dfitzsimo-svg/PFD_Project2/Pictures/3D PCB (routing done) (Draft 1).png

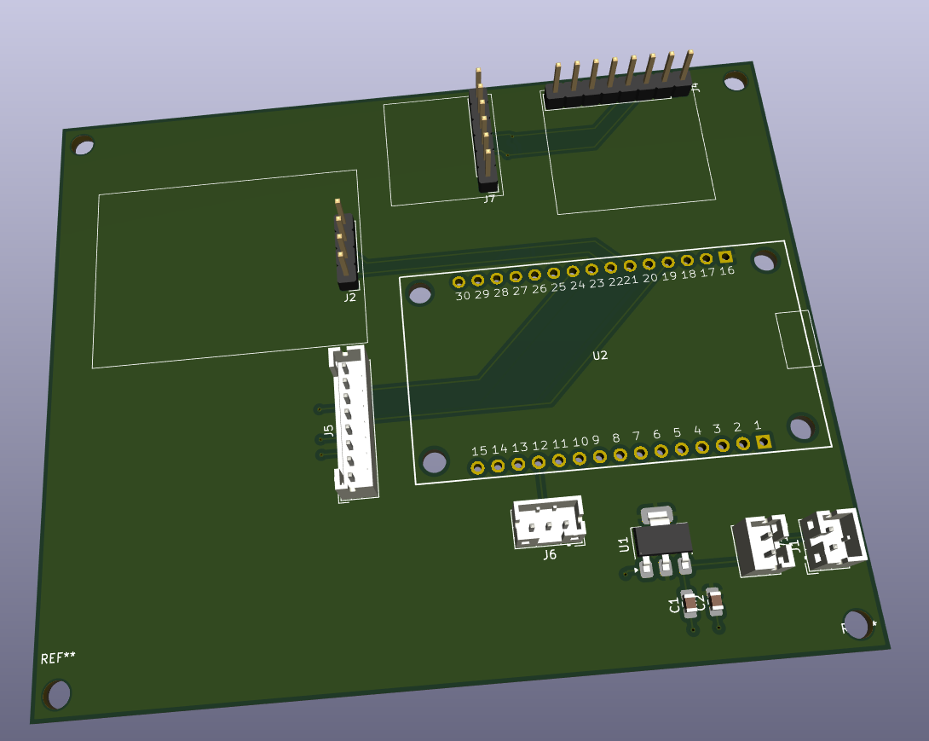
Pictures/3D PCB (routing done) (Draft 1).png
