dfitzsimo-svg/PFD_Project2/Pictures/Final PCB Design.png

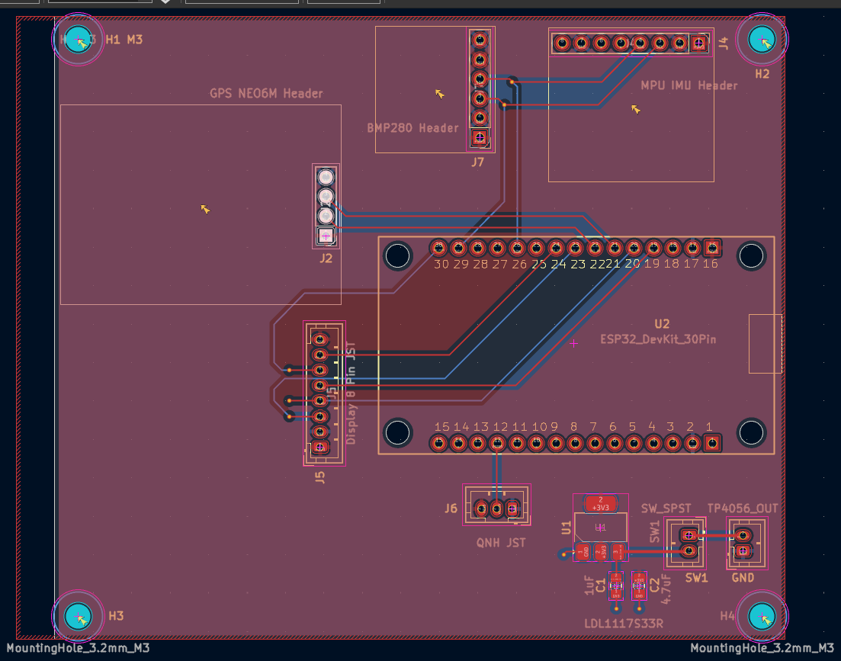
Pictures/Final PCB Design.png
