dfitzsimo-svg/PFD_Project2/Pictures/Laying out traces on PCB.png

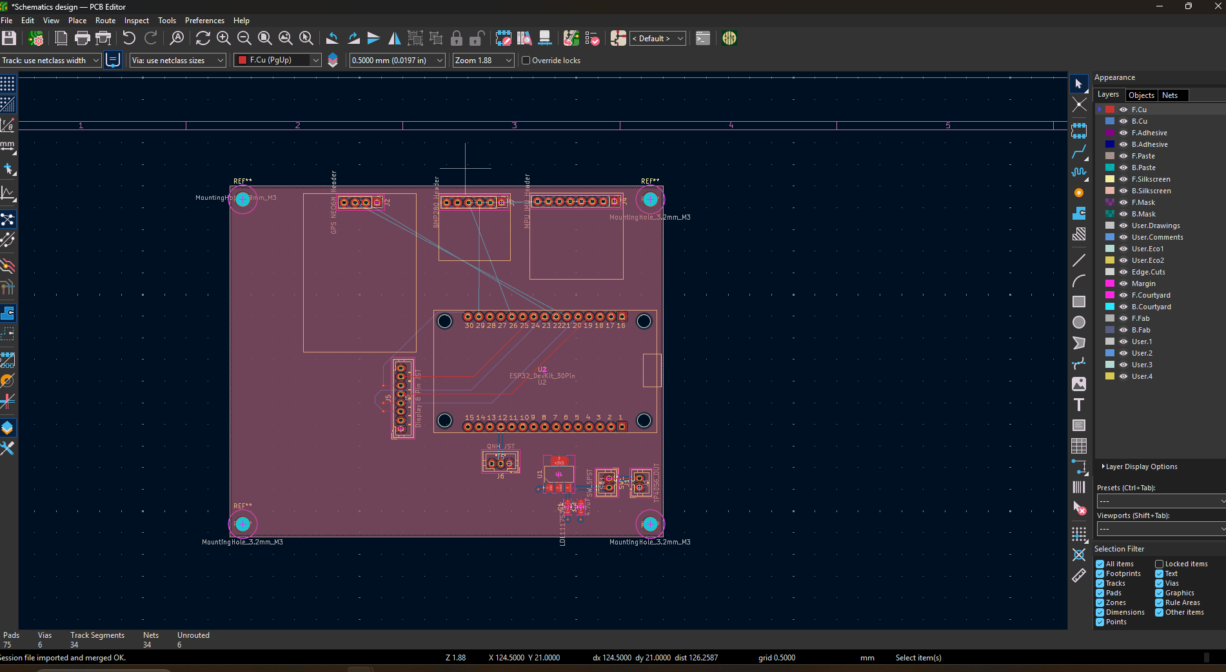
Pictures/Laying out traces on PCB.png
