dfitzsimo-svg/PFD_Project2/Pictures/Prelayout PCB Editor (W Footprints).png

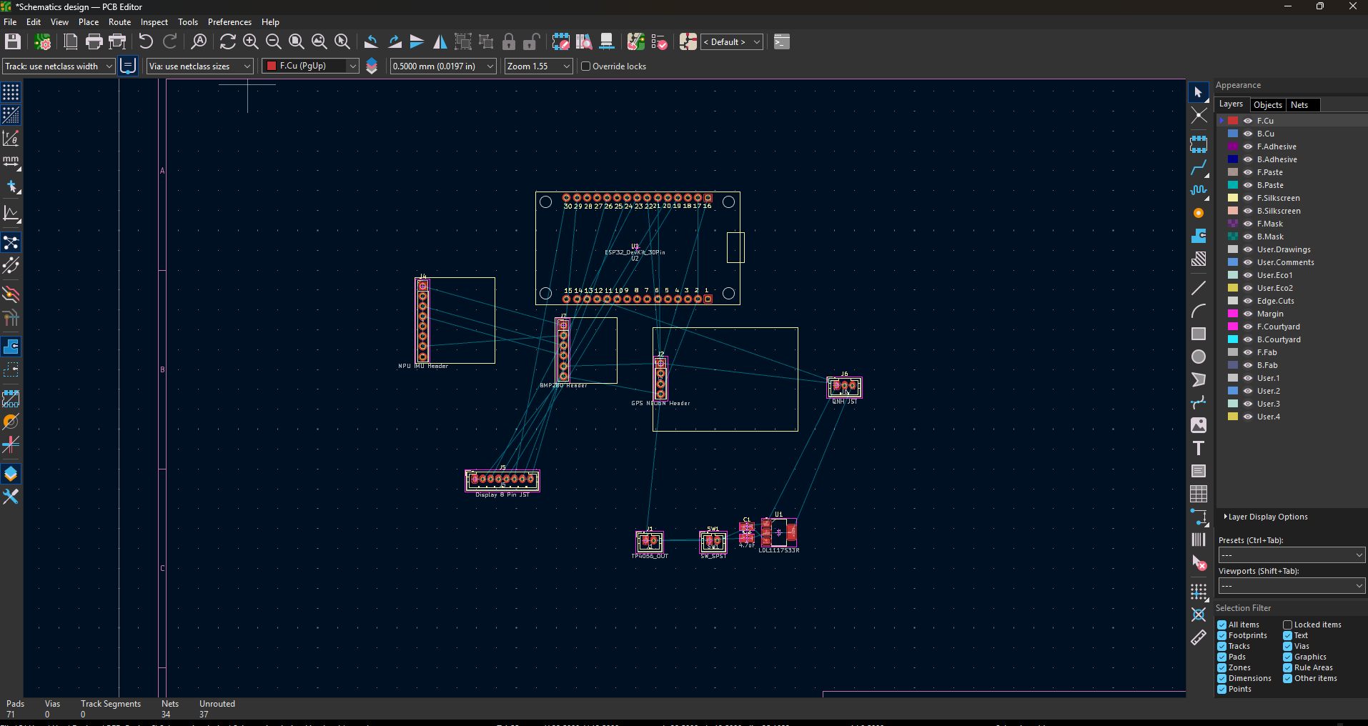
Pictures/Prelayout PCB Editor (W Footprints).png
