dfitzsimo-svg/PFD_Project2/Components and Datasheets/Onshape notes.txt

Onshape notes:

Screen pin dimensions: 
92 mm across
49.5 mm vertical
From spec sheet

screen size: 52 x 76.5
Behind screen size: 57 x 87
