dfitzsimo-svg/PFD_Project2/Schematics design/Schematics design.step

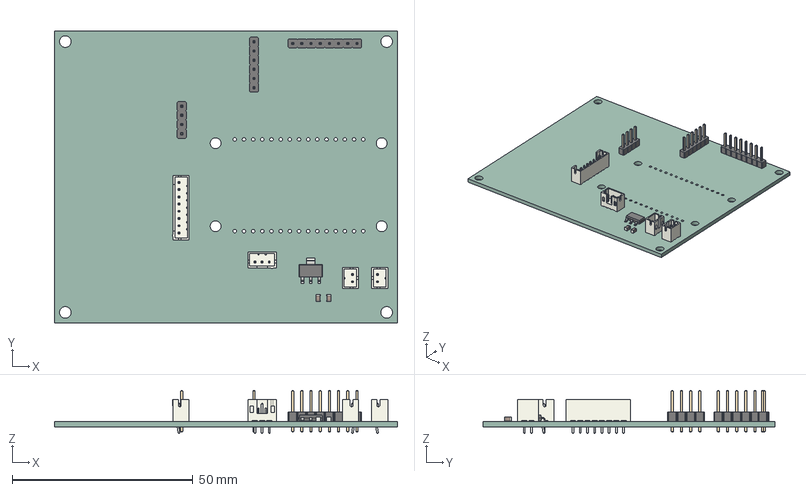
[picture p5: CAD file, 2026-11-07]
Schematics design/Schematics design.step
95.0 x 81.0 x 11.9 mm
PinHeader_1x04_P254mm_Vertical
PinHeader_1x08_P254mm_Vertical
C_0805_2012Metric x 2
JST_B3B_PH_K
JST_B8B_PH_K
PinHeader_1x06_P254mm_Vertical
JST_B2B_PH_K x 2
SOT-223
Sch3B9F_PCB
