dfitzsimo-svg/PFD_Project2/3d Prints/V1/Tub V1.stl

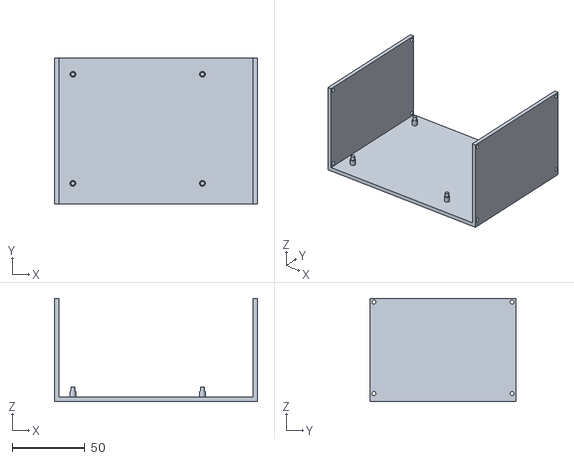
[picture p6: CAD file, 2026-11-07, an earlier design]
3d Prints/V1/Tub V1.stl
139.5 x 100.0 x 70.9
