dfitzsimo-svg/PFD_Project2/ESP to ILI9488 Wiring Table.txt

ESP to ILI9488 Wiring Table

VCC        - 3.3V     
GND        - GND
CS         - GPIO 5
RESET      - GPIO 4
DC (D/C)   - GPIO 2
SDI (MOSI) - GPIO 23
SCK        - GPIO 18
LED        - 3.3V  
SDO (MISO) - GPIO 19
