dfitzsimo-svg/PFD_Project2/Git guide.txt

Git guide

git status : check whats changed

See previous versions: 
git log --oneline
Or for a cleaner version:
git log --oneline --graph --decorate

See whats changed before you commit: 
git diff
git diff tape_boxes.py (For a specific file)

Gihub day to day commands:

git status
git add .
git commit -m "Describe what changed"
git push
