dfitzsimo-svg/PFD_Project2/Schematics design/Schematics design.kicad_pcb

## KiCad design Schematics design/Schematics design.kicad_pcb (2026-11-07)

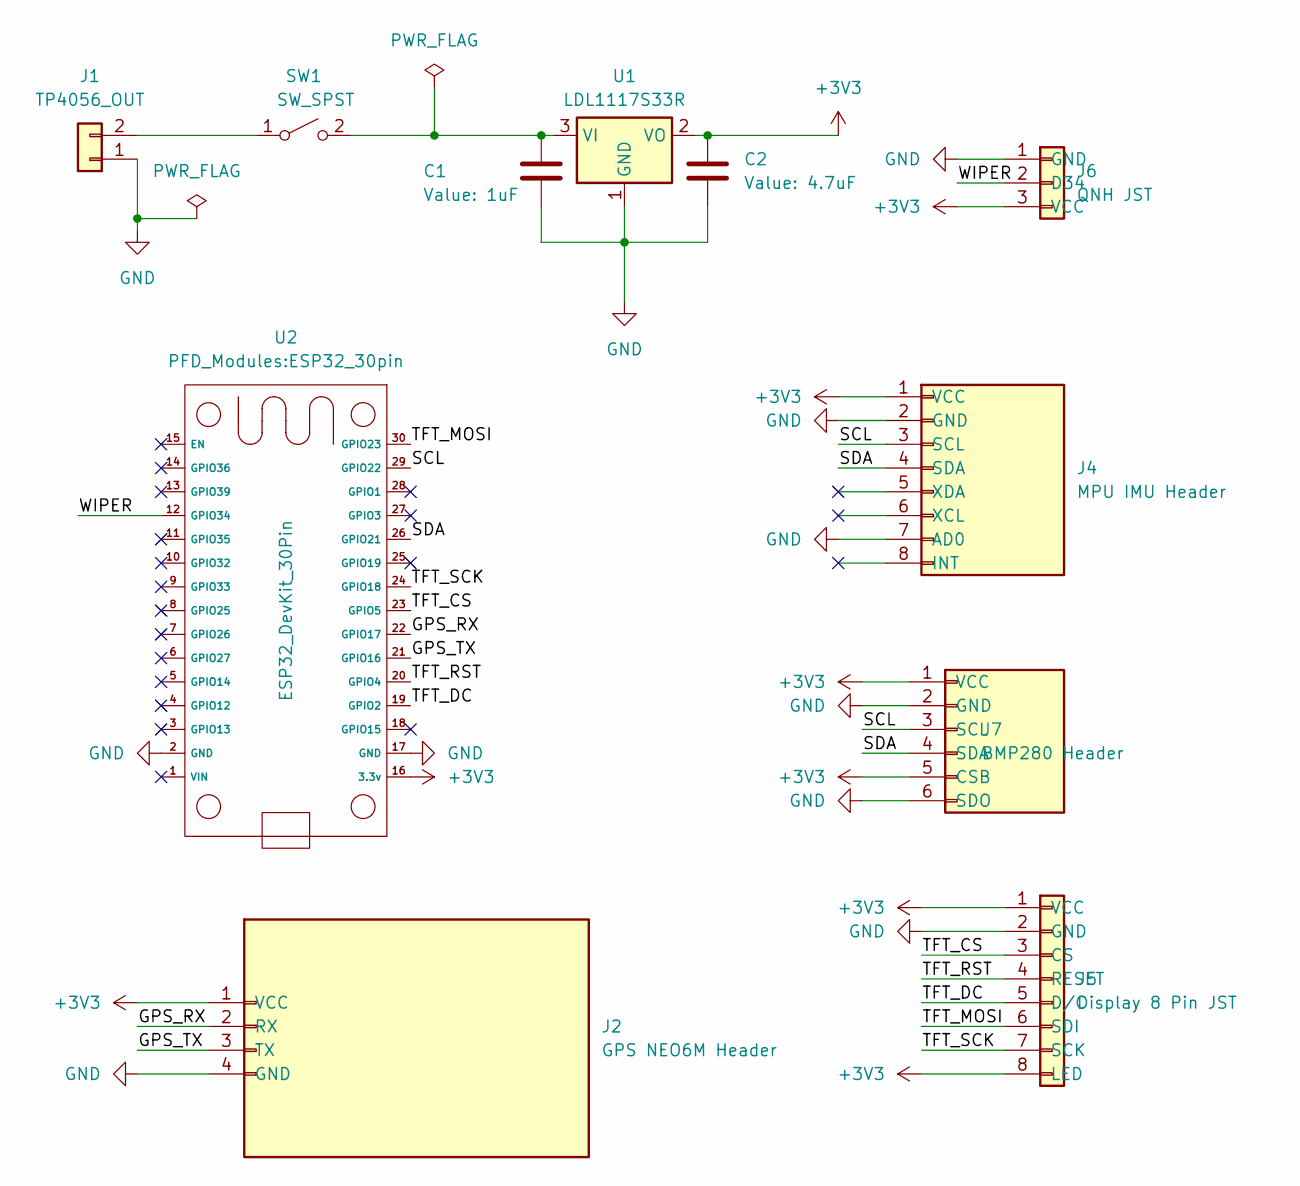
[picture p7: schematic Schematics design.kicad_sch, PFD Carrier Board]

Parts:
C1: 1uF; C_0805_2012Metric_Pad1.18x1.45mm_HandSolder
C2: 4.7uF; C_0805_2012Metric_Pad1.18x1.45mm_HandSolder
J1: TP4056_OUT; JST_PH_B2B-PH-K_1x02_P2.00mm_Vertical
J2: GPS NEO6M Header; PinHeader_1x04_P2.54mm_Vertical
J4: MPU IMU Header; PinHeader_1x08_P2.54mm_Vertical
J5: Display 8 Pin JST; JST_PH_B8B-PH-K_1x08_P2.00mm_Vertical
J6: QNH JST; JST_PH_B3B-PH-K_1x03_P2.00mm_Vertical
J7: BMP280 Header; PinHeader_1x06_P2.54mm_Vertical
SW1: SW_SPST; JST_PH_B2B-PH-K_1x02_P2.00mm_Vertical
U1: LDL1117S33R; SOT-223-3_TabPin2
U2: ESP32_DevKit_30Pin; ESP32_30pin

Connections:
+3V3: C2.2, J2.1 (VCC), J4.1 (VCC), J5.1 (VCC), J5.8 (LED), J6.3 (VCC), J7.1 (VCC), J7.5 (CSB), U1.2 (VO), U2.16 (3.3v)
/GPS_RX: J2.2 (RX), U2.22 (GPIO17)
/GPS_TX: J2.3 (TX), U2.21 (GPIO16)
/SCL: J4.3 (SCL), J7.3 (SCL), U2.29 (GPIO22)
/SDA: J4.4 (SDA), J7.4 (SDA), U2.26 (GPIO21)
/TFT_CS: J5.3 (CS), U2.23 (GPIO5)
/TFT_DC: J5.5 (D/C), U2.19 (GPIO2)
/TFT_MOSI: J5.6 (SDI), U2.30 (GPIO23)
/TFT_RST: J5.4 (RESET), U2.20 (GPIO4)
/TFT_SCK: J5.7 (SCK), U2.24 (GPIO18)
/WIPER: J6.2 (D34), U2.12 (GPIO34)
GND: C1.1, C2.1, J1.1, J2.4 (GND), J4.2 (GND), J4.7 (AD0), J5.2 (GND), J6.1 (GND), J7.2 (GND), J7.6 (SDO), U1.1 (GND), U2.2 (GND), U2.17 (GND); also elsewhere on the board
unnamed 12: J1.2, SW1.1 (A); also elsewhere on the board
unnamed: C1.2, SW1.2 (B), U1.3 (VI)

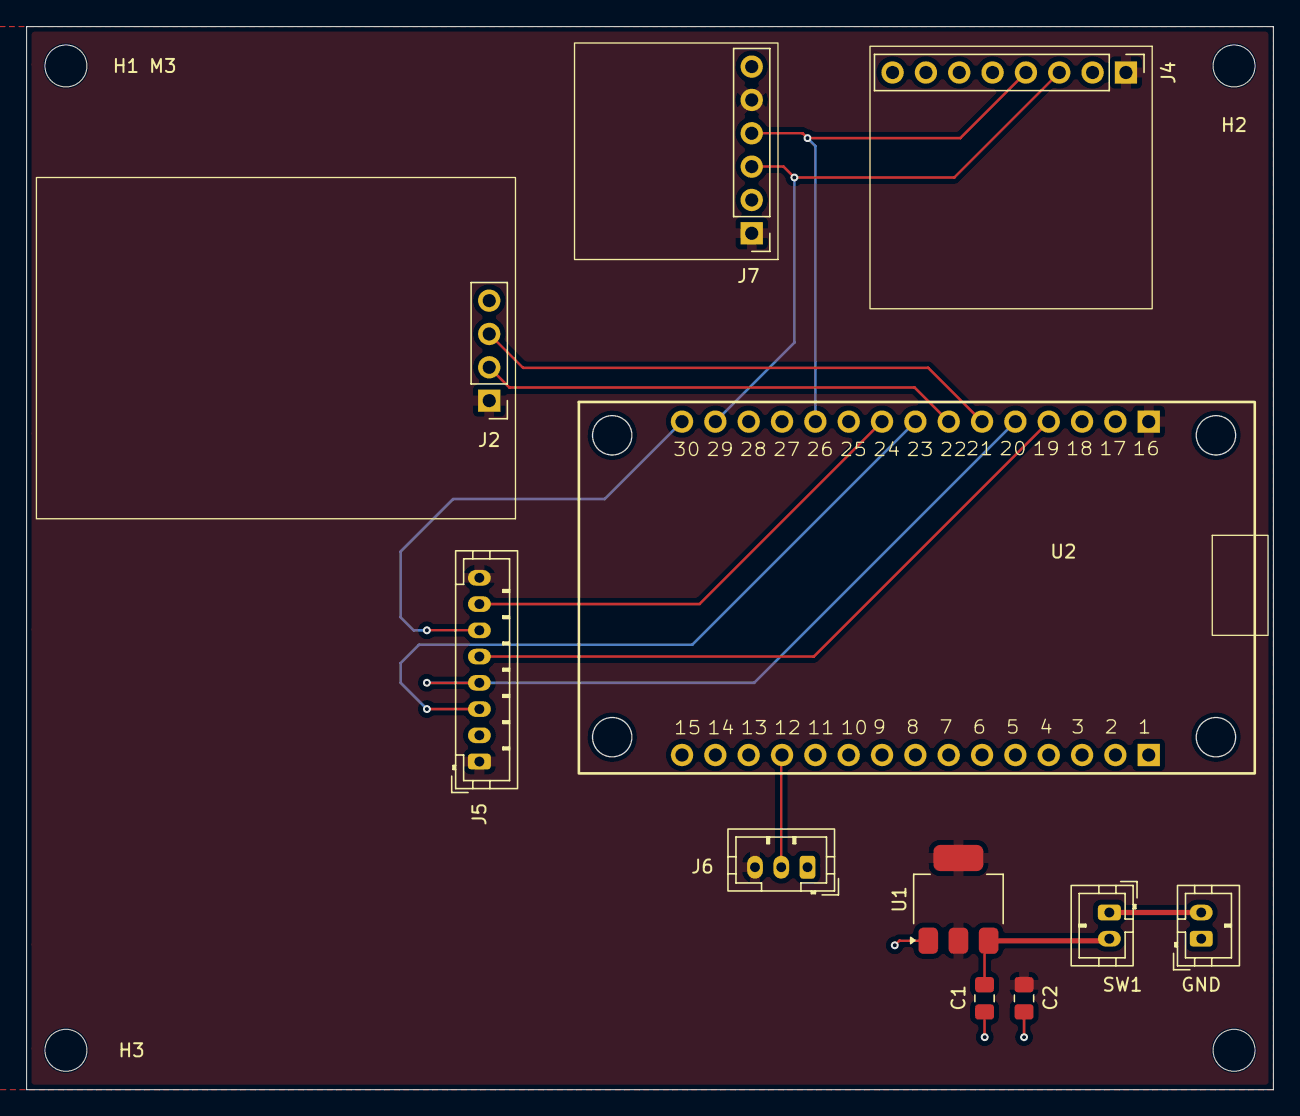
[picture p8: board Schematics design.kicad_pcb from above]

Board: 2 copper layers, 95.0 x 81.0 mm, 14 parts (0 on the bottom side), 14 nets.

Other parts of the board:
GND: TP4056_OUT; JST_PH_B2B-PH-K_1x02_P2.00mm_Vertical
H1 M3, H3: MountingHole_3.2mm_M3
H2: M3; MountingHole_3.2mm_M3

Their connections:
GND: GND.1; also elsewhere on the board
unnamed 12: GND.2; also elsewhere on the board
