dfitzsimo-svg/PFD_Project2/(commit log)

2026-08-02 Add ESP32 Arduino port - banded rendering, all six modules
2026-08-02 Removed old Pi wiring diagrams
2026-09-28 Updating code to read in sensor data
2026-10-08 Schematic complete: power, ESP32, display, GPS, IMU, baro, QNH - ERC clean
2026-11-07 Added some notes files and 3d print files
